GunnarBostrom/ECE-5780-Project-GBJCTS/README.md

# ECE-5780-Project-GBJCTS: Simple Quadcopter
This is the final project for an embedded systems design course.

This project involves developing a simple quadcopter to demonstrate proficiency in communication protocols, system control, as well as sensor and actuator integration.

Weekly Milestones:
1. Development environment & hardware setup  
2. ESC control and motor PWM output  
3. RF radio receiver interface & IMU sensor interface  
4. LiDAR interface & peripheral integration  
5. State estimation (sensor fusion and filtering)  
6. Control & safety systems implementation  
7. PID tuning & flight testing  

## Hardware Components
**Flight Controller:** STM32F072 Discovery Board  
**IMU:** LSM6DS3 on a NOYITO breakout board  
**Altitude Sensor:** VL53L1X on an Adafruit breakout board  
**Radio:** Team BlackSheep Crossfire Nano  
**ESCs:** XILO 40A BLHeli_S ESC  
**Motors:** EMAX ECO II 2207 2400KV  
**Power:** 4S LiPo battery  
**Voltage Regulator:** MatekSys Micro BEC  

**Quadcopter Frame:** GEPRC GEP-Mark4 5"  
**Propellers:** HQProp Ethix S3  

<p align="center" style="display: flex; justify-content: center; gap: 50px;">
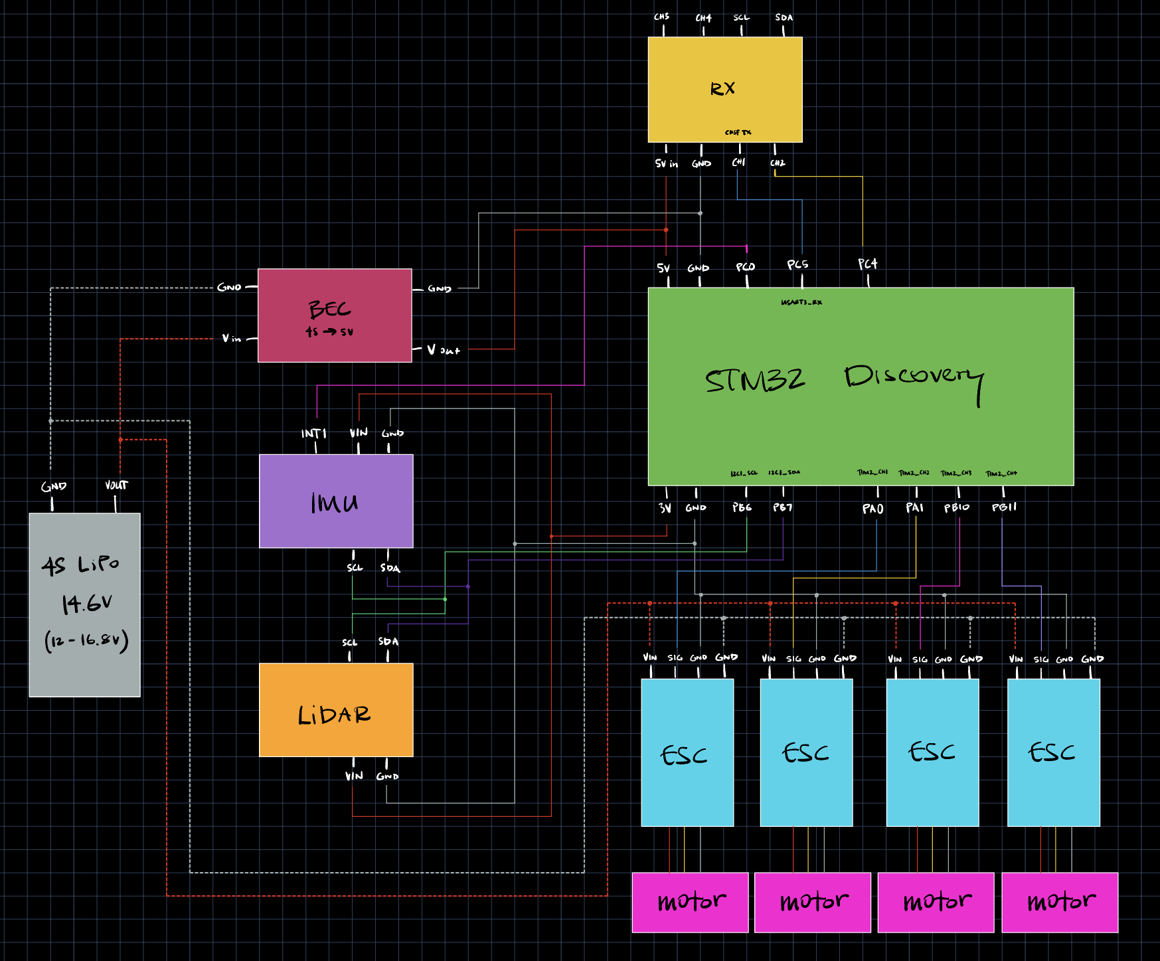
[picture p1: docs/simple_drone_wire_diagram.png]
Wiring Diagram
  
</p>

## Features & Progress

### Planned
- radio controlled thrust input (altitude control)
- stable flight (pitch and roll axes)
- fixed altitude hover

### Current Progress
- Simulator and optimizer to tune PIDs in 4 axes
- Motor control via PWM
- RF radio link integrated via UART
- IMU data read via I2C
- Hardware integrated
- Rough PID tune

## Toolchain
This project uses a bare-metal embedded toolchain based on GCC, CMake, and OpenOCD.

### Required Tools
- **GNU ARM Embedded Toolchain** (compiler)  
- **CMake** (build system)  
- **OpenOCD** (flashing/debugging)  
- **ST-Link** (hardware debug probe)

### Toolchain Installation

#### macOS
[Install Homebrew](https://brew.sh/) if needed.

```bash
brew install --cask gcc-arm-embedded
brew install cmake
brew install openocd
brew install stlink
```

#### Linux
```bash
sudo apt update
sudo apt install gcc-arm-none-eabi
sudo apt install binutils-arm-none-eabi
sudo apt install cmake
sudo apt install openocd
sudo apt install stlink-tools
```

#### Windows
Recommended to use Windows Subsystem for Linux. [Install WSL](https://learn.microsoft.com/en-us/windows/wsl/install) and use the Linux instructions above.  

### Setup
Create a file called config_local.h in the /inc/ directory and copy the code below into it.
This is local config file that allows for the independent testing of different peripherals by multiple devs. Adjust the 1s and 0s according to what peripheral is to be included in the build.

```c
/*
THIS FILE IS GITIGNORED.
This config file is per dev settings and overrides the default.
*/

#pragma once

/*
Override for what peripherals you have.
1 = HAVE
0 = DON'T HAVE
*/
#define USE_RADIO 1
#define USE_IMU 1
#define USE_LIDAR 0
#define USE_MOTOR 1
#define USE_DEBUGGER 1
```

### Build & Flash
Generate build files:  
`cmake -B build -S ./` (regular build)  
`cmake -B build -S ./ -DCMAKE_BUILD_TYPE=Debug` (build and include debug symbols for GDB)  
Compile:  
`cmake --build build`  
Flash to board:  
`cmake --build build --target flash_project`

### Debug and Testing
Run OpenOCD:  
`openocd -f interface/stlink.cfg -f target/stm32f0x.cfg &`  
Run GDB:  
`arm-none-eabi-gdb build/project.elf`  
`target remote :3333`  
`load`  
Then set breakpoints and step through or continue as needed.

## Project Info
**Status:** Flight tests and PID tuning  
**Language:** C  
**License:** MIT License – see [LICENSE](./LICENSE)  
**Authors:** [G. Bostrom](https://github.com/GunnarBostrom), [J. Canada](https://github.com/JC919), [T. Stratton](https://github.com/POACH3)  
**Semester:** Spring 2026  
**Start Date:** 17-MAR-2026
