GunnarBostrom/ECE-5780-Project-GBJCTS/inc/motor.h

#ifndef MOTOR_H_
#define MOTOR_H_

#include <stdint.h>

// -------------------------------------------------------------------------------------------------
// Initialization
// -------------------------------------------------------------------------------------------------
void motor_init(void);

// -------------------------------------------------------------------------------------------------
// Motor Commands (pulse width in microseconds)
// Valid range: 1000 - 2000 us
// -------------------------------------------------------------------------------------------------
void motor_set_all(uint16_t pulse_us);
void motor_set_individual(uint16_t m1, uint16_t m2, uint16_t m3, uint16_t m4);

#endif
