GunnarBostrom/ECE-5780-Project-GBJCTS/src/imu.c

/**
imu.c
LSM6DS3 Driver

STM LSM6DS3
LSM6DS3 can operate at 100 kHz or 400 kHz.

Data peripheral provides:
    - 3 axis acceleration
    - 3 axis angular rate
    - temperature
*/

#include "config.h"
#include "imu.h"
#include "i2c.h"

// copied in just for debugging with LEDs
#include "stm32f072xb.h"
#include "stm32f0xx_hal.h"
#include "stm32f0xx_hal_gpio.h"
#include "stm32f0xx_it.h"
#include <stdint.h>
#include <stdio.h>
#include <sys/_intsup.h>
#include <sys/types.h>

#define IMU_ADDR 0x6B   // default I2C slave address
// #define IMU_ADDR      0x6A  // another I2C slave address option
#define WHO_AM_I_REG    0x0F
#define DEVICE_ID       0x69


/* ––––– output registers ––––– */
#define ACCEL_REG       0x28  // OUTX_L_XL - lowest accel output register
#define GYRO_REG        0x22  // OUTX_L_G - lowest gyro output register
#define TEMP_REG        0x20  // OUT_TEMP_L - lowest temp output register


/* ––––– configuration registers ––––– */
#define ACCEL_CFG       0x10  // CTRL1_XL - accelerometer control register
#define GYRO_CFG        0x11  // CTRL2_G - gyroscope control register
#define INT1_CFG        0x0D  // INT1_CTRL - interrupt1 control register
#define INT2_CFG        0x0E  // INT2_CTRL - interrupt2 control register

#define CTRL3_C         0x12  // these are for interrupts
#define CTRL4_C         0x13


/* ––––– accelerometer config values ––––– */
// 12.5 Hz to 6.66 kHz ODR available, default is Power-down
#define ACCEL_ODR_104HZ  (0b0100 << 4)
#define ACCEL_ODR_208HZ  (0b0101 << 4)
#define ACCEL_ODR_416HZ  (0b0110 << 4)

// ±2 g to ±16 g full-scale available, default is ±2 g
#define ACCEL_FS_2G      (0b00 << 2)
#define ACCEL_FS_4G      (0b10 << 2)
#define ACCEL_FS_8G      (0b11 << 2)
#define ACCEL_FS_16G     (0b01 << 2)

// 50 Hz to 400 Hz anti-aliasing available, default is 400 Hz
#define ACCEL_BW_200HZ   (0b01 << 0)
#define ACCEL_BW_400HZ   (0b00 << 0)


/* ––––– gyroscope config values ––––– */
// 12.5 Hz to 1.66 kHz ODR available, default is Power-down
#define GYRO_ODR_104HZ   (0b0100 << 4)
#define GYRO_ODR_208HZ   (0b0101 << 4)
#define GYRO_ODR_416HZ   (0b0110 << 4)

// 125 dps to 2000 dps full-scale available, default is 250 dps
#define GYRO_FS_500DPS   (0b10 << 2)  
#define GYRO_FS_2000DPS  (0b11 << 2)
#define GYRO_FS_125DPS   (0b1  << 1) // 125 dps enabled overrides other modes


/* ––––– interrupt config values ––––– */
// data ready registers disabled by default
#define INT1_GYRO_EN     (0b1 << 1)  // INT1_DRDY_G
#define INT1_ACCEL_EN    (0b1 << 0)  // INT1_DRDY_XL

#define INT2_TEMP_EN     (0b1 << 2)  // INT2_DRDY_TEMP
#define INT2_GYRO_EN     (0b1 << 1)  // INT2_DRDY_G
#define INT2_ACCEL_EN    (0b1 << 0)  // INT2_DRDY_XL


/* ––––– scaling to account for lack of FPU on STM32F0 board ––––– */
// accelerometer full-scale conversion mg/LSB --> ±32767 or 32768?
#define A_FS_2           0.061f // 2 g  =  2000 mg
#define A_FS_4           0.122f
#define A_FS_8           0.244f
#define A_FS_16          0.488f
static const float accel_scale_g_per_lsb = 0.000244f; // ±8 g

// gyroscope full-scale conversion mdps/LSB --> ±28571
#define G_FS_125         4.375f // 125 dps  =  125000 mdps
#define G_FS_250         8.75f
#define G_FS_500         17.5f
#define G_FS_1000        35
#define G_FS_2000        70
static const float gyro_scale_dps_per_lsb = 0.070f; // 2000 dps

#define CAL_SAMPLES      416

static void convert_units(LSM6DS3_t* imu);

static float gx_offset = 0, gy_offset = 0, gz_offset = 0;
static float ax_offset = 0, ay_offset = 0, az_offset = 0;

volatile uint8_t imu_ready = 0;


#if USE_IMU // use REAL hardware

/**
 * @brief LSM6DS3 configuration and initialization.
 * 
 * Hard-coded configs:
 *      - accelerometer: 416Hz data rate, ±8g full-scale, 400Hz anti-aliasing
 *      - gyroscope:     416Hz data rate, 2000 dps full-scale
 * 
 * @param imu           Pointer to IMU struct
 */
void imu_init(LSM6DS3_t* imu) {

    uint8_t device_id;
    i2c_read(IMU_ADDR, WHO_AM_I_REG, &device_id, 1);

    if (device_id != DEVICE_ID) {
        // wrong device detected
        // blink blue + orange LEDs
        while (1) {
            HAL_GPIO_TogglePin(GPIOC, GPIO_PIN_7);
            HAL_GPIO_TogglePin(GPIOC, GPIO_PIN_8);
            HAL_Delay(200);
        }
    }

    // BDU    = 1  -> block data update
    // IF_INC = 1  -> auto-increment register addresses for burst reads
    //
    // 0x44 = 0100 0100b
    uint8_t ctrl3 = 0x44;
    i2c_write(IMU_ADDR, CTRL3_C, &ctrl3, 1);

    // mask data-ready until output data has settled
    uint8_t ctrl4 = 0x08;
    i2c_write(IMU_ADDR, CTRL4_C, &ctrl4, 1);

    // data configs
    uint8_t accel_config = ACCEL_ODR_416HZ | ACCEL_FS_8G | ACCEL_BW_400HZ;
    i2c_write(IMU_ADDR, ACCEL_CFG, &accel_config, 1);

    uint8_t gyro_config = GYRO_ODR_416HZ | GYRO_FS_2000DPS;
    i2c_write(IMU_ADDR, GYRO_CFG, &gyro_config, 1);

    // startup filter settling time
    HAL_Delay(100);

    // interrupts
    uint8_t int1_config = INT1_GYRO_EN | INT1_ACCEL_EN;
    i2c_write(IMU_ADDR, INT1_CFG, &int1_config, 1);
}

// record average offset
void imu_calibrate(LSM6DS3_t *imu) {

  for (int i = 0; i < CAL_SAMPLES; i++) {
    while (!imu_ready) {} // wait
    imu_ready = 0;

    imu_read(imu);

    gx_offset += imu->gx;
    gy_offset += imu->gy;
    gz_offset += imu->gz;
    ax_offset += imu->ax;
    ay_offset += imu->ay;
    az_offset += imu->az;
  }

  gx_offset /= CAL_SAMPLES;
  gy_offset /= CAL_SAMPLES;
  gz_offset /= CAL_SAMPLES;
  ax_offset /= CAL_SAMPLES;
  ay_offset /= CAL_SAMPLES;
  az_offset /= CAL_SAMPLES;
  az_offset -= 1.0f / accel_scale_g_per_lsb; // subtract 1g in raw counts
  // az should read 1g at rest, so subtract gravity

}

/**
 * @brief Reads all inertial data (this does not include temperature).
 * 
 * This IMU has an auto-increment feature, allowing the access all in one
 * shot of the data in a register as well as the n bytes desired after it.
 * Hence the gyro data is accessed first because it is the lowest register.
 */
void imu_read(LSM6DS3_t* imu) {
  uint8_t buf[12];

  i2c_read(IMU_ADDR, GYRO_REG, buf, 12);
  imu->gx = (int16_t)(buf[0] | buf[1] << 8);
  imu->gy = (int16_t)(buf[2] | buf[3] << 8);
  imu->gz = (int16_t)(buf[4] | buf[5] << 8);
  imu->ax = (int16_t)(buf[6] | buf[7] << 8);
  imu->ay = (int16_t)(buf[8] | buf[9] << 8);
  imu->az = (int16_t)(buf[10] | buf[11] << 8);
  convert_units(imu);
}

// Reads IMU gyroscope data
void imu_read_gyro(LSM6DS3_t *imu) {
  uint8_t buf[6]; // 6 bytes: X, Y, Z (2 bytes each)

  i2c_read(IMU_ADDR, GYRO_REG, buf, 6);
  imu->gx = (int16_t)(buf[0] | buf[1] << 8);
  imu->gy = (int16_t)(buf[2] | buf[3] << 8);
  imu->gz = (int16_t)(buf[4] | buf[5] << 8);
  convert_units(imu);
}

//Reads IMU acceleration data
void imu_read_accel(LSM6DS3_t* imu) {
  uint8_t buf[6]; // 6 bytes: X, Y, Z (2 bytes each)

  i2c_read(IMU_ADDR, ACCEL_REG, buf, 6);
  imu->ax = (int16_t)(buf[0] | buf[1] << 8);
  imu->ay = (int16_t)(buf[2] | buf[3] << 8);
  imu->az = (int16_t)(buf[4] | buf[5] << 8);
  convert_units(imu);
}

// Reads IMU temperature data
void imu_read_temp(LSM6DS3_t* imu) {
  uint8_t buf[2];

  i2c_read(IMU_ADDR, TEMP_REG, buf, 2);
  //imu->temp = (int16_t)(buf[0] | (buf[1] << 8));
  //convert_units(imu);
}

// Reads all IMU data (including temperature)
void imu_read_all(LSM6DS3_t* imu) {
    uint8_t buf[14];

    i2c_read(IMU_ADDR, TEMP_REG, buf, 14);
    //imu->temp = (int16_t)(buf[0] | (buf[1] << 8));
    imu->gx = (int16_t)(buf[2]  | buf[3]  << 8);
    imu->gy = (int16_t)(buf[4]  | buf[5]  << 8);
    imu->gz = (int16_t)(buf[6]  | buf[7]  << 8);
    imu->ax = (int16_t)(buf[8]  | buf[9]  << 8);
    imu->ay = (int16_t)(buf[10] | buf[11] << 8);
    imu->az = (int16_t)(buf[12] | buf[13] << 8);
    convert_units(imu);
}

// corrects raw values and converts to physical units
static void convert_units(LSM6DS3_t* imu) {
    // imu->gx_mdps = imu->gx * G_FS_2000;
    // imu->gy_mdps = imu->gy * G_FS_2000;
    // imu->gz_mdps = imu->gz * G_FS_2000;
    // imu->ax_mg = imu->ax * A_FS_8;
    // imu->ay_mg = imu->ay * A_FS_8;
    // imu->az_mg = imu->az * A_FS_8;

    imu->gx_dps = (float)(imu->gx - gx_offset) * gyro_scale_dps_per_lsb;
    imu->gy_dps = (float)(imu->gy - gy_offset) * gyro_scale_dps_per_lsb;
    imu->gz_dps = (float)(imu->gz - gz_offset) * gyro_scale_dps_per_lsb;
    imu->ax_g = (float)(imu->ax - ax_offset) * accel_scale_g_per_lsb;
    imu->ay_g = (float)(imu->ay - ay_offset) * accel_scale_g_per_lsb;
    imu->az_g = (float)(imu->az - az_offset) * accel_scale_g_per_lsb;

    // conversion to celsius is:
    // celsius_temp = (raw_temp / 16) + 25  (± the offset error)
}

#else // use FAKE hardware
void imu_init(LSM6DS3_t* imu) { /* do nothing */ }
void imu_read(LSM6DS3_t* imu) { /* do nothing */ }
void imu_read_accel(LSM6DS3_t* imu) { /* do nothing */ }
void imu_read_gyro(LSM6DS3_t* imu) { /* do nothing */ }
void imu_read_temp(LSM6DS3_t* imu) { /* do nothing */ }
void imu_read_all(LSM6DS3_t* imu) { /* do nothing */ }
static void calibrate(LSM6DS3_t *imu) { /* do nothing */ }
static void convert_units(LSM6DS3_t* imu) { /* do nothing */ }
#endif
