GunnarBostrom/ECE-5780-Project-GBJCTS/inc/config_default.h

// This config file assumes that all peripherals are used unless overridden

#ifndef USE_RADIO
    #define USE_RADIO 1
#endif
#ifndef USE_IMU
    #define USE_IMU 1
#endif
#ifndef USE_LIDAR
    #define USE_LIDAR 1
#endif
#ifndef USE_MOTOR
    #define USE_MOTOR 1
#endif
#ifndef USE_DEBUGGER
    #define USE_DEBUGGER 1
#endif
