GunnarBostrom/ECE-5780-Project-GBJCTS/(commit log)

2026-03-26 Initial single-axis PID algorthim simulation
2026-04-02 Stub out I2C
2026-04-02 Working 4-motor PWM output, baseline idle at 1200
2026-04-03 Add LSM6DS3 IMU driver
2026-04-03 Add most of i2c
2026-04-03 Stub out LiDAR driver
2026-04-03 Updated main.c with motor control testing
2026-04-04 Remove I2C freq from struct, minor refactor
2026-04-04 Debug i2c_write_transaction, add comments
2026-04-04 Add wiring diagram
2026-04-04 Add lidar_init and defines
2026-04-04 Link to VL53L1X driver, clean up top level CMakeLists
2026-04-04 Link to VL53L1X driver
2026-04-08 Debug I2C and IMU drivers, polling IMU functional in I2C Standard-mode with 8MHz clock
2026-04-08 got rid of debugging LEDs
2026-04-08 Update timing prescalar to 48Mhz clock in motor.c
2026-04-08 Fix LiDAR errors
2026-04-08 setting up for motor and radio test
2026-04-08 Did control function and added to main. Lidar was causing issues so uncomment that out
    [control.c, main.c, radio.c, radio.h]
2026-04-09 Fix bug preventing I2C Fast-mode in i2c_bus_reset()
    [i2c.c, main.c]
2026-04-09 Uncomment i2c initialization
2026-04-09 Update milestones and current progress
2026-04-09 Add I2C1 through PB6 and PB7
2026-04-09 Add interrupt for IMU
2026-04-15 Initial attempt at complementary filter
2026-04-15 Added conversion for raw IMU values
2026-04-16 Fixing issues for build
    [imu.c, radio.h]
2026-04-16 Refactor main control loop for IMU driven interrupt updates and add documentation and comments to control structure
2026-04-16 Working control loop with pitch and roll correction commands
    [control.c, imu.c, main.c, pid.c, radio.c]
2026-04-16 Removed unused files to pare down firmware: main_opt.c and pwm.c
2026-04-23 Improve throttle-up control behavior by removing the 50 Hz motor-output bottleneck. Increased to 400 Hz
2026-04-23 Add better comments for PID section code
2026-04-26 Revert to old tuning code
    [control.c]
2026-04-27 Update IMU
2026-04-27 Fix imu data type
    [control.c, control.h]
2026-04-27 Add debugger and IMU print statement
2026-04-27 Add IMU calibration
2026-04-27 Add motor debug prints
